samalsubrat/arion-aryabhatta/kicad source/wired&wireless led diagram.png

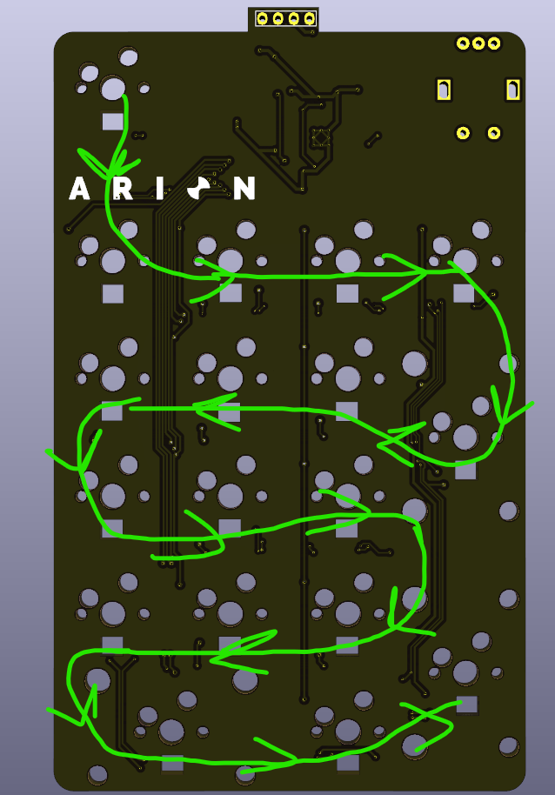
kicad source/wired&wireless led diagram.png
