samalsubrat/arion-aryabhatta/kicad source/WiredPcb/wired.step

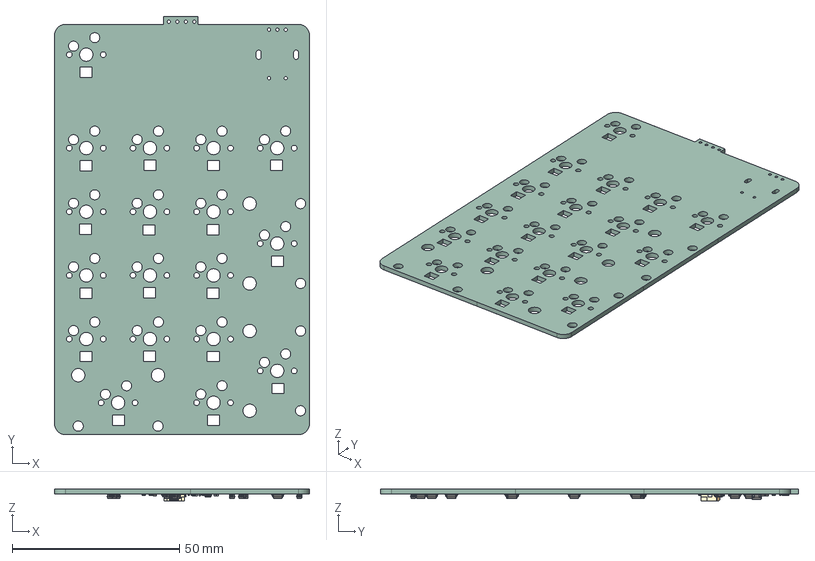
[picture p2: CAD file, 2025-07-30]
kicad source/WiredPcb/wired.step
76.3 x 125.2 x 3.60 mm
D_SOD-123 x 19
C_0402_1005Metric x 14
Fuse_0603_1608Metric
R_0402_1005Metric x 12
SOT-23-5
Crystal_SMD_2520-4Pin_2.5x2.0mm
lock
pins
WIRED_PCB
