samalsubrat/arion-aryabhatta/kicad source/WirelessPcb/WIRELESS.step

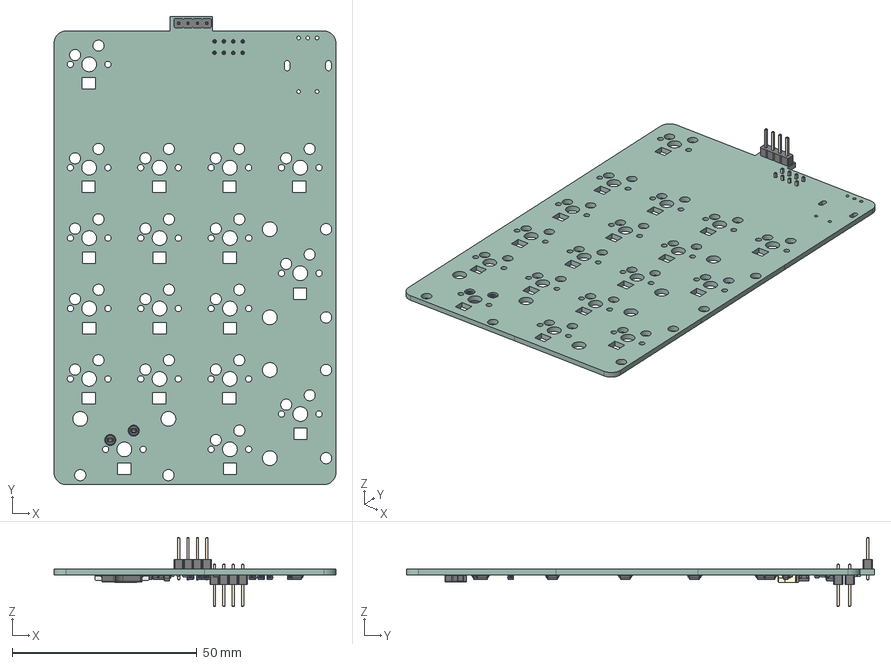
[picture p3: CAD file, 2025-07-30]
kicad source/WirelessPcb/WIRELESS.step
76.3 x 126.8 x 18.8 mm
PinHeader_1x04_P2.54mm_Vertical x 3
SOT-23 x 2
D_SOD-323F
R_0603_1608Metric x 5
SOT-23-5 x 2
Crystal_SMD_MicroCrystal_CM9V-T1A-2Pin_1.6x1.0mm
D_SOD-123 x 19
R_0402_1005Metric x 4
MX-Hotswap-Socket
lock
pins
WIRELESS_PCB
