samalsubrat/arion-aryabhatta/kicad source/db wireless/Unified-Daughterboard.kicad_pcb

## KiCad design kicad source/db wireless/Unified-Daughterboard.kicad_pcb (2025-07-30)

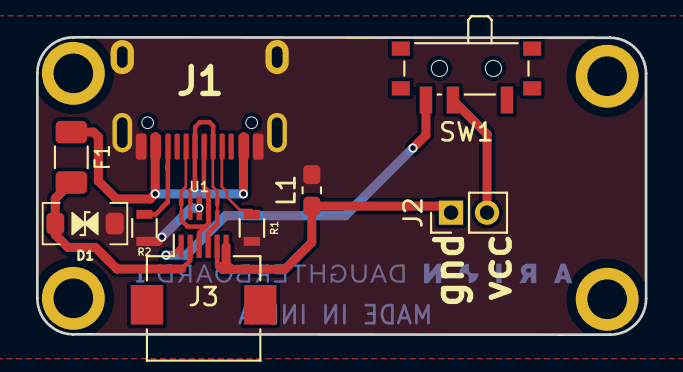
[picture p4: board Unified-Daughterboard.kicad_pcb from above]

Board: 2 copper layers, 33.8 x 16.5 mm, 14 parts (0 on the bottom side), 10 nets.

Parts:
D1: SMF9.0CA; D_SOD-123_Bidirectional
F1: ASMD1206-150; Fuse_1206_3216Metric
J1: TYPE-C-31-M12_13; TYPE-C-31-M-12
J2: Conn_01x02_Socket; PinHeader_1x02_P2.00mm_Vertical
J3: Conn_01x06_Pin; Hirose_FH12-6S-0.5SH_1x06-1MP_P0.50mm_Horizontal
L1: 60R@100MHz; L_0603_1608Metric_Pad1.05x0.95mm_HandSolder
MH1, MH3, MH4, MH4#2: Mount-M2; Generic-Mounthole
R1, R2: 5.1k; R_0603
SW1: SW_DPDT_x2; SW_SPDT_PCM12
U1: TPD4E05U06DQAR; USON-10_2.5x1.0mm_P0.5mm

Connections:
DA+: J1.A6 (D+), J1.B6 (D+), J3.3, U1.1 (IO1), U1.4 (D2+), U1.7 (NC), U1.10 (NC)
DA-: J1.A7 (D-), J1.B7 (D-), J3.4, U1.2 (IO2), U1.5 (D2-), U1.6 (NC), U1.9 (NC)
GND: J2.1, J3.5, J3.6, L1.1
GNDPWR: D1.1 (A1), J1.A1 (GND), J1.B1 (GND), J1.S (SHIELD), L1.2, R1.2, R2.2, U1.3 (GND), U1.8 (GND)
unnamed: J1.A5 (CC1), R1.1
unnamed: J1.B5 (CC2), R2.1
VBUS: F1.1, J1.A4 (VBUS), J1.B4 (VBUS)
VCC: D1.2 (A2), F1.2, J3.2
bat in: J2.2, SW1.2 (B)
bat+: J3.1, SW1.3 (C)
