samalsubrat/arion-aryabhatta/kicad source/WiredPcb/WIRED.kicad_pcb

## KiCad design kicad source/WiredPcb/WIRED.kicad_pcb (2025-07-30)

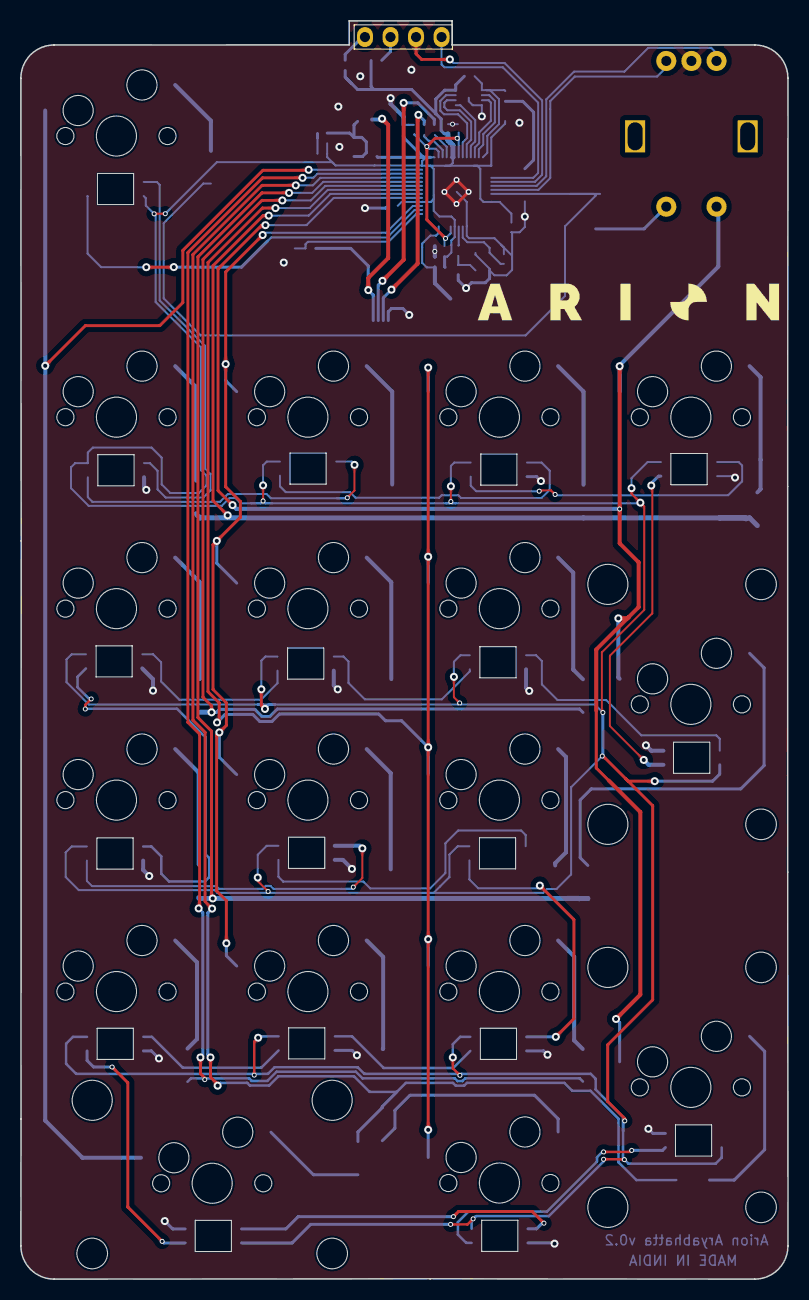
[picture p5: board WIRED.kicad_pcb from above]

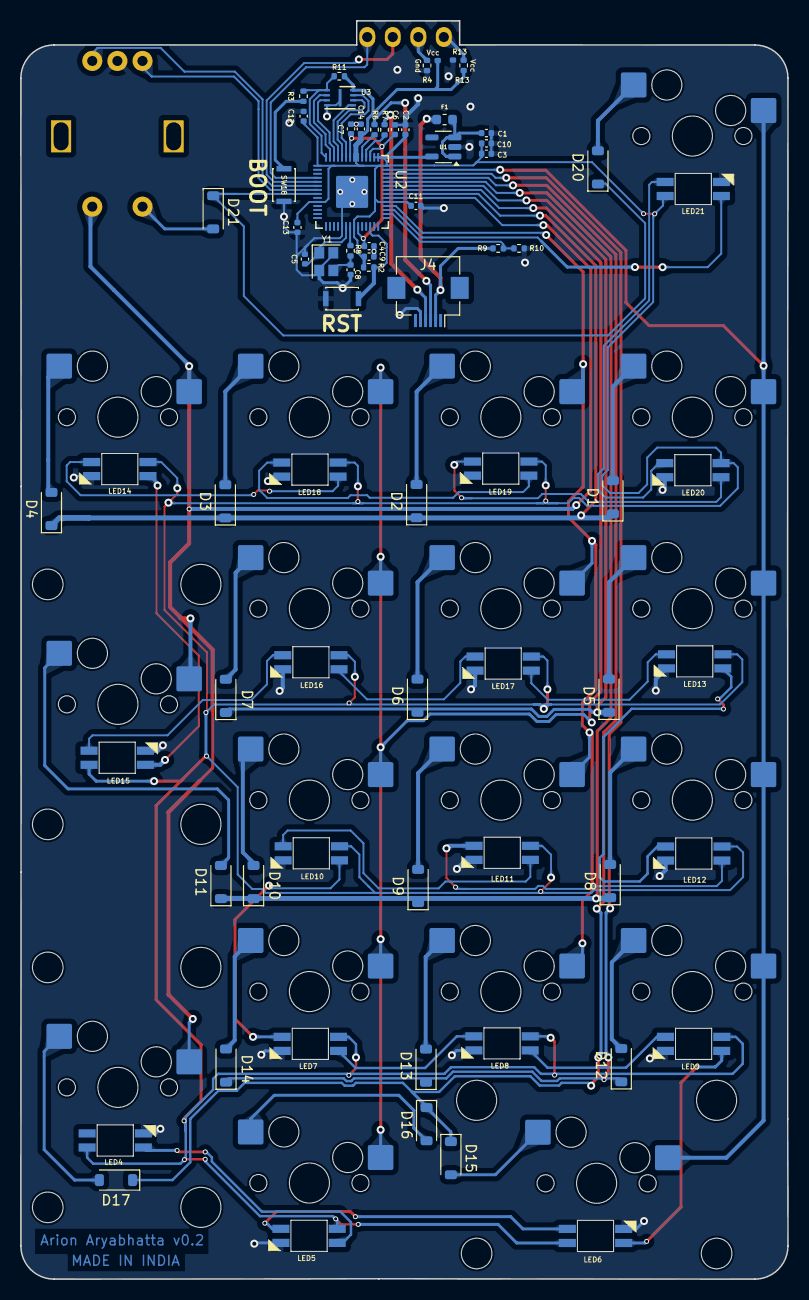
[picture p6: board WIRED.kicad_pcb from below]

Board: 2 copper layers, 76.3 x 125.2 mm, 91 parts (89 on the bottom side), 74 nets.

Parts:
C1, C2, C3, C4: 1µ; C_0402_1005Metric
C5, C8: 15p; C_0402_1005Metric
C6, C7, C9, C10, C11, C12, C13, C14: 100n; C_0402_1005Metric
D1, D2, D3, D4, D5, D6, D7, D8, D9, D10, D11, D12, D13, D14, D15, D16, D17, D20, D21: 1N4148W; D_SOD-123
F1: Polyfuse; Fuse_0603_1608Metric
J3: Conn_01x04_Pin; 128x64OLED
J4: Conn_01x06_Socket; Hirose_FH12-6S-0.5SH_1x06-1MP_P0.50mm_Horizontal
LED4, LED5, LED6, LED7, LED8, LED9, LED10, LED11, LED12, LED13, LED14, LED15, LED16, LED17, LED18, LED19, LED20, LED21: YS-SK6812MINI-E
R1, R4, R12, R13: 0k; R_0402_1005Metric
R2, R10, R11: 10k; R_0402_1005Metric
R3, R8: 1k; R_0402_1005Metric
R6, R7: 27; R_0402_1005Metric
R9: 5.1k; R_0402_1005Metric
SW0, SW1, SW2, SW3, SW4, SW5, SW6, SW8, SW9, SW10, SW11, SW12, SW13, SW16, SW20: KEYSW; MX-Hotswap-1U
SW7, SW14: KEYSW; MX-Hotswap-2U-Vertical-ReversedStabilizers
SW15: KEYSW; MX-Hotswap-2U-ReversedStabilizers
SW17, SW18: SW_Push; SW_SPST_CK_KXT3
SW19: Rotary_Encoder_Switch; RotaryEncoder_Alps_EC11E-Switch_Vertical_H20mm-keebio_modif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
U1: XC6210B332MR-G; SOT-23-5
U2: U2; QFN-56-1EP_7x7mm_P0.4mm_EP3.2x3.2mm
U3: U3; USON-8-1EP_3x2mm_P0.5mm_EP0.25x1.65mm
Y1: Crystal_GND24; Crystal_SMD_2520-4Pin_2.5x2.0mm

Connections:
+1V1: C4.1, C6.1, C7.1, U2.23 (DVDD), U2.45 (VREG_VOUT), U2.50 (DVDD)
+3V3: C2.1, C3.1, C9.1, C10.1, C11.1, C12.1, C13.1, C14.1, LED4.1 (VDD), LED5.1 (VDD), LED6.1 (VDD), LED7.1 (VDD), LED8.1 (VDD), LED9.1 (VDD), LED10.1 (VDD), LED11.1 (VDD), LED12.1 (VDD), LED13.1 (VDD), LED14.1 (VDD), LED15.1 (VDD), LED16.1 (VDD), LED17.1 (VDD), LED18.1 (VDD), LED19.1 (VDD), LED20.1 (VDD), LED21.1 (VDD), R1.2, R2.2, R11.2, R13.2, U1.5 (VOUT), U2.1 (IOVDD), U2.10 (IOVDD), U2.22 (IOVDD), U2.33 (IOVDD), U2.42 (IOVDD), U2.43 (ADC_AVDD), U2.44 (VREG_IN), U2.48 (USB_VDD), U2.49 (IOVDD), U3.8 (VCC)
+5V: C1.1, F1.2, U1.1 (VIN), U1.3 (EN)
/D+: J4.3, R6.1
/D-: J4.4, R7.1
/QSPI_D0: U2.53 (QSPI_SD0), U3.5 (DI(IO0))
/QSPI_D1: U2.55 (QSPI_SD1), U3.2 (DO(IO1))
/QSPI_D2: U2.54 (QSPI_SD2), U3.3 (IO2)
/QSPI_D3: U2.51 (QSPI_SD3), U3.7 (IO3)
/QSPI_SCLK: U2.52 (QSPI_SCLK), U3.6 (CLK)
/QSPI_~CS: R3.2, R11.1, U2.56 (QSPI_SS), U3.1 (~CS)
/VBUS_DET: R9.1, R10.2, U2.30 (GPIO19)
/~RESET: R2.1, SW17.2, U2.26 (RUN/~RST)
ENCA: SW19.A, U2.6 (GPIO4)
ENCB: SW19.B, U2.7 (GPIO5)
GND: C1.2, C2.2, C3.2, C4.2, C5.2, C6.2, C7.2, C8.2, C9.2, C10.2, C11.2, C12.2, C13.2, C14.2, J4.5, LED4.3 (VSS), LED5.3 (VSS), LED6.3 (VSS), LED7.3 (VSS), LED8.3 (VSS), LED9.3 (VSS), LED10.3 (VSS), LED11.3 (VSS), LED12.3 (VSS), LED13.3 (VSS), LED14.3 (VSS), LED15.3 (VSS), LED16.3 (VSS), LED17.3 (VSS), LED18.3 (VSS), LED19.3 (VSS), LED20.3 (VSS), LED21.3 (VSS), R4.1, R10.1, R12.1, SW17.1, SW18.1, SW19.C, U1.2 (GND), U2.19 (TESTEN), U2.57 (GND), U3.4 (GND), U3.9 (EP), Y1.2, Y1.4
LEDIN: LED21.4 (DIN), U2.31 (GPIO20)
unnamed: C8.1, R8.1, Y1.3
unnamed: D1.2 (A), SW0.2
unnamed: D2.2 (A), SW1.2
unnamed: D3.2 (A), SW2.2
unnamed: D4.2 (A), SW3.2
unnamed: D5.2 (A), SW4.2
unnamed: D6.2 (A), SW5.2
unnamed: D7.2 (A), SW6.2
unnamed: D8.2 (A), SW8.2
unnamed: D9.2 (A), SW9.2
unnamed: D10.2 (A), SW10.2
unnamed: D11.2 (A), SW7.2
unnamed: D12.2 (A), SW11.2
unnamed: D13.2 (A), SW12.2
unnamed: D14.2 (A), SW13.2
unnamed: D15.2 (A), SW15.2
unnamed: D16.2 (A), SW16.2
unnamed: D17.2 (A), SW14.2
unnamed: D20.2 (A), SW20.2
unnamed: D21.2 (A), SW19.S1
unnamed: J3.1, R13.1
unnamed: J3.2, R4.2
unnamed: LED4.4 (DIN), LED5.2 (DOUT)
unnamed: LED5.4 (DIN), LED6.2 (DOUT)
unnamed: LED6.4 (DIN), LED9.2 (DOUT)
unnamed: LED7.2 (DOUT), LED8.4 (DIN)
unnamed: LED8.2 (DOUT), LED9.4 (DIN)
unnamed: LED10.4 (DIN), LED11.2 (DOUT)
unnamed: LED7.4 (DIN), LED10.2 (DOUT)
unnamed: LED11.4 (DIN), LED12.2 (DOUT)
unnamed: LED12.4 (DIN), LED13.2 (DOUT)
unnamed: LED13.4 (DIN), LED17.2 (DOUT)
unnamed: LED14.4 (DIN), LED18.2 (DOUT)
unnamed: LED14.2 (DOUT), LED15.4 (DIN)
unnamed: LED15.2 (DOUT), LED16.4 (DIN)
unnamed: LED16.2 (DOUT), LED17.4 (DIN)
unnamed: LED18.4 (DIN), LED19.2 (DOUT)
unnamed: LED19.4 (DIN), LED20.2 (DOUT)
unnamed: LED20.4 (DIN), LED21.2 (DOUT)
unnamed: R3.1, SW18.2
unnamed: R7.2, U2.46 (USB_DM)
unnamed: R6.2, U2.47 (USB_DP)
unnamed: C5.1, U2.20 (XIN), Y1.1
unnamed: R8.2, U2.21 (XOUT)
VBUS: F1.1, J4.2, R9.2
col0: SW0.1, SW4.1, SW8.1, SW11.1, SW15.1, SW20.1, U2.41 (GPIO29_ADC3)
col1: SW1.1, SW5.1, SW9.1, SW12.1, U2.32 (GPIO21)
col2: SW2.1, SW6.1, SW10.1, SW13.1, SW16.1, U2.36 (GPIO24)
col3: SW3.1, SW7.1, SW14.1, SW19.S2, U2.34 (GPIO22)
row0: D1.1 (K), D2.1 (K), D3.1 (K), D4.1 (K), U2.35 (GPIO23)
row1: D5.1 (K), D6.1 (K), D7.1 (K), U2.37 (GPIO25)
row2: D8.1 (K), D9.1 (K), D10.1 (K), D11.1 (K), U2.38 (GPIO26_ADC0)
row3: D12.1 (K), D13.1 (K), D14.1 (K), U2.40 (GPIO28_ADC2)
row4: D15.1 (K), D16.1 (K), D17.1 (K), U2.39 (GPIO27_ADC1)
row5: D20.1 (K), D21.1 (K), U2.8 (GPIO6)
sda: J3.4, U2.4 (GPIO2)
sdl: J3.3, U2.5 (GPIO3)
