samalsubrat/arion-aryabhatta/kicad source/WirelessPcb/WIRELESS.kicad_pcb

## KiCad design kicad source/WirelessPcb/WIRELESS.kicad_pcb (2025-07-30)

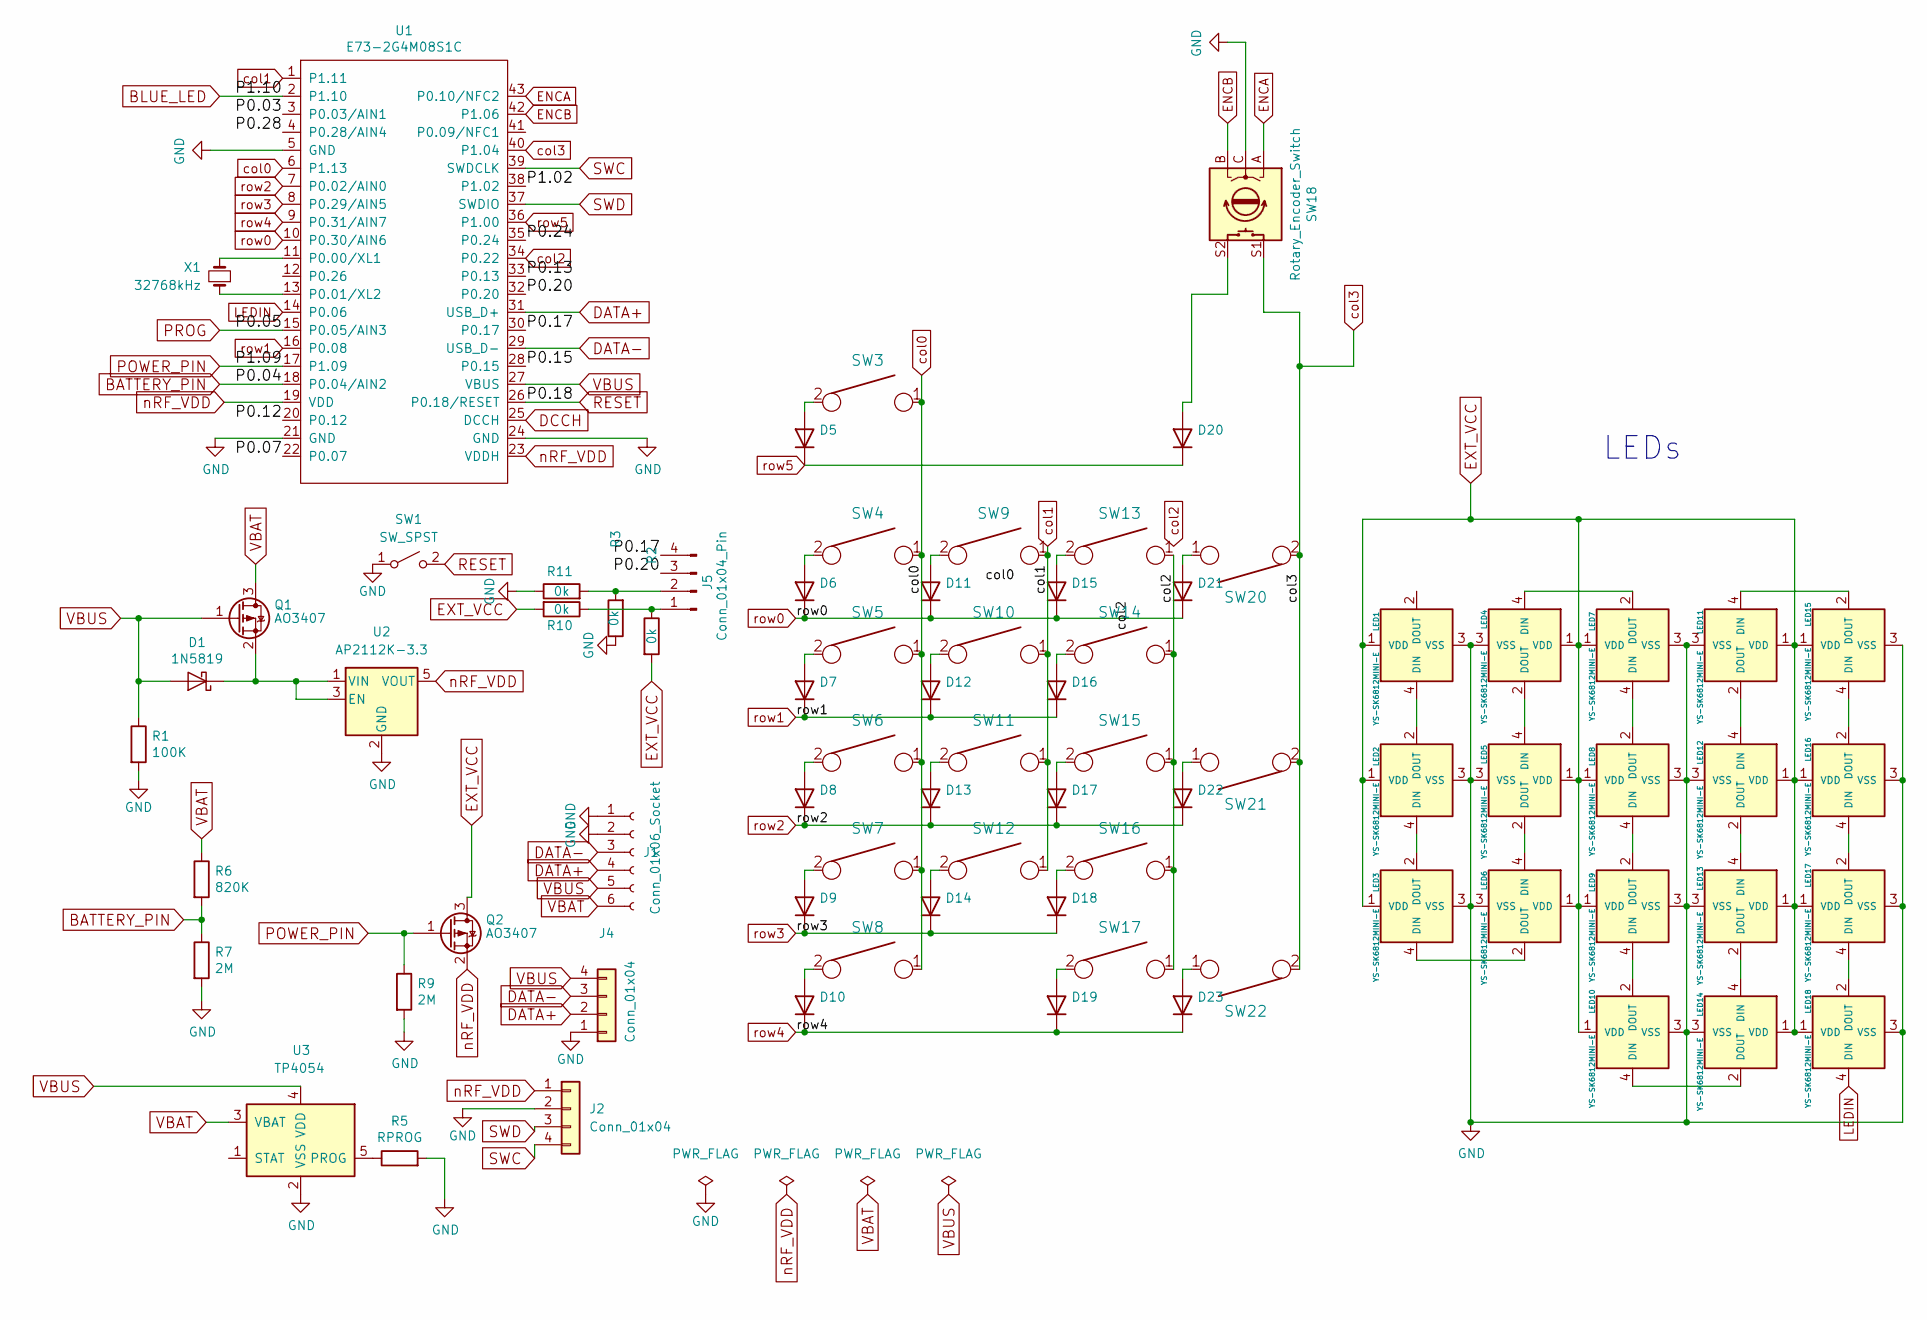
[picture p7: schematic WIRELESS.kicad_sch]

Parts:
D1: 1N5819; D_SOD-323F
D5, D6, D7, D8, D9, D10, D11, D12, D13, D14, D15, D16, D17, D18, D19, D20, D21, D22, D23: D_SOD-123
J1: Conn_01x06_Socket; Hirose_FH12-6S-0.5SH_1x06-1MP_P0.50mm_Horizontal
J2, J4: Conn_01x04; PinHeader_1x04_P2.54mm_Vertical
J5: Conn_01x04_Pin; PinHeader_1x04_P2.54mm_Vertical
LED1, LED2, LED3, LED4, LED5, LED6, LED7, LED8, LED9, LED10, LED11, LED12, LED13, LED14, LED15, LED16, LED17, LED18: YS-SK6812MINI-E
Q1, Q2: AO3407; SOT-23
R1: 100K; R_0603_1608Metric
R2, R3, R10, R11: 0k; R_0402_1005Metric; LCSC C25744
R5: RPROG; R_0603_1608Metric
R6: 820K; R_0603_1608Metric
R7, R9: 2M; R_0603_1608Metric
SW1: SW_SPST; SW_SPST_CK_KXT3
SW3, SW4, SW5, SW6, SW7, SW9, SW10, SW11, SW12, SW13, SW14, SW15, SW16, SW17, SW20: KEYSW; MX-Hotswap-1U
SW8: KEYSW; MX-Hotswap-2U-ReversedStabilizers
SW18: Rotary_Encoder_Switch; RotaryEncoder_Alps_EC11E-Switch_Vertical_H20mm-keebio_modif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
SW21, SW22: KEYSW; MX-Hotswap-2U-Vertical-ReversedStabilizers
U1: E73-2G4M08S1C; E73-2G4M08S1C-52840
U2: AP2112K-3.3; SOT-23-5
U3: TP4054; SOT-23-5
X1: 32768kHz

Connections:
/P0.03: U1.3 (P0.03/AIN1)
/P0.07: U1.22 (P0.07)
/P0.12: U1.20 (P0.12)
/P0.13: U1.33 (P0.13)
/P0.15: U1.28 (P0.15)
/P0.17: J5.4, U1.30 (P0.17)
/P0.20: J5.3, U1.32 (P0.20)
/P0.24: U1.35 (P0.24)
/P0.28: U1.4 (P0.28/AIN4)
/P1.02: U1.38 (P1.02)
BATTERY_PIN: R6.2, R7.1, U1.18 (P0.04/AIN2)
BLUE_LED: U1.2 (P1.10)
DATA+: J1.4, J4.2, U1.31 (USB_D+)
DATA-: J1.3, J4.3, U1.29 (USB_D-)
DCCH: U1.25 (DCCH)
ENCA: SW18.A, U1.43 (P0.10/NFC2)
ENCB: SW18.B, U1.42 (P1.06)
EXT_VCC: LED1.1 (VDD), LED2.1 (VDD), LED3.1 (VDD), LED4.1 (VDD), LED5.1 (VDD), LED6.1 (VDD), LED7.1 (VDD), LED8.1 (VDD), LED9.1 (VDD), LED10.1 (VDD), LED11.1 (VDD), LED12.1 (VDD), LED13.1 (VDD), LED14.1 (VDD), LED15.1 (VDD), LED16.1 (VDD), LED17.1 (VDD), LED18.1 (VDD), Q2.3 (D), R2.2, R10.2
GND: J1.1, J1.2, J2.2, J4.1, LED1.3 (VSS), LED2.3 (VSS), LED3.3 (VSS), LED4.3 (VSS), LED5.3 (VSS), LED6.3 (VSS), LED7.3 (VSS), LED8.3 (VSS), LED9.3 (VSS), LED10.3 (VSS), LED11.3 (VSS), LED12.3 (VSS), LED13.3 (VSS), LED14.3 (VSS), LED15.3 (VSS), LED16.3 (VSS), LED17.3 (VSS), LED18.3 (VSS), R1.2, R3.1, R5.2, R7.2, R9.2, R11.1, SW1.1 (A), SW18.C, U1.5 (GND), U1.21 (GND), U1.24 (GND), U2.2 (GND), U3.2 (VSS); also elsewhere on the board
LEDIN: LED18.4 (DIN), U1.14 (P0.06)
unnamed: D1.1 (K), Q1.2 (S), U2.1 (VIN), U2.3 (EN)
unnamed: D5.2 (A), SW3.2
unnamed: D6.2 (A), SW4.2
unnamed: D7.2 (A), SW5.2
unnamed: D8.2 (A), SW6.2
unnamed: D9.2 (A), SW7.2
unnamed: D10.2 (A), SW8.2
unnamed: D11.2 (A), SW9.2
unnamed: D12.2 (A), SW10.2
unnamed: D13.2 (A), SW11.2
unnamed: D14.2 (A), SW12.2
unnamed: D15.2 (A), SW13.2
unnamed: D16.2 (A), SW14.2
unnamed: D17.2 (A), SW15.2
unnamed: D18.2 (A), SW16.2
unnamed: D19.2 (A), SW17.2
unnamed: D20.2 (A), SW18.S2
unnamed: D21.2 (A), SW20.1
unnamed: D22.2 (A), SW21.1
unnamed: D23.2 (A), SW22.1
unnamed: J5.1, R2.1, R10.1
unnamed: J5.2, R3.2, R11.2
unnamed: LED1.4 (DIN), LED2.2 (DOUT)
unnamed: LED2.4 (DIN), LED3.2 (DOUT)
unnamed: LED3.4 (DIN), LED6.2 (DOUT)
unnamed: LED4.4 (DIN), LED7.2 (DOUT)
unnamed: LED4.2 (DOUT), LED5.4 (DIN)
unnamed: LED5.2 (DOUT), LED6.4 (DIN)
unnamed: LED7.4 (DIN), LED8.2 (DOUT)
unnamed: LED8.4 (DIN), LED9.2 (DOUT)
unnamed: LED10.4 (DIN), LED14.2 (DOUT)
unnamed: LED9.4 (DIN), LED10.2 (DOUT)
unnamed: LED11.4 (DIN), LED15.2 (DOUT)
unnamed: LED11.2 (DOUT), LED12.4 (DIN)
unnamed: LED12.2 (DOUT), LED13.4 (DIN)
unnamed: LED13.2 (DOUT), LED14.4 (DIN)
unnamed: LED15.4 (DIN), LED16.2 (DOUT)
unnamed: LED16.4 (DIN), LED17.2 (DOUT)
unnamed: LED17.4 (DIN), LED18.2 (DOUT)
unnamed: U1.11 (P0.00/XL1), X1.2
unnamed: U1.13 (P0.01/XL2), X1.1
unnamed: R5.1, U3.5 (PROG)
POWER_PIN: Q2.1 (G), R9.1, U1.17 (P1.09)
PROG: U1.15 (P0.05/AIN3)
RESET: SW1.2 (B), U1.26 (P0.18/RESET); also elsewhere on the board
SWC: J2.4, U1.39 (SWDCLK)
SWD: J2.3, U1.37 (SWDIO)
VBAT: J1.6, Q1.3 (D), R6.1, U3.3 (VBAT)
VBUS: D1.2 (A), J1.5, J4.4, Q1.1 (G), R1.1, U1.27 (VBUS), U3.4 (VDD)
col0: SW3.1, SW4.1, SW5.1, SW6.1, SW7.1, SW8.1, U1.6 (P1.13)
col1: SW9.1, SW10.1, SW11.1, SW12.1, U1.1 (P1.11)
col2: SW13.1, SW14.1, SW15.1, SW16.1, SW17.1, U1.34 (P0.22)
col3: SW18.S1, SW20.2, SW21.2, SW22.2, U1.40 (P1.04)
nRF_VDD: J2.1, Q2.2 (S), U1.19 (VDD), U1.23 (VDDH), U2.5 (VOUT)
row0: D6.1 (K), D11.1 (K), D15.1 (K), D21.1 (K), U1.10 (P0.30/AIN6)
row1: D7.1 (K), D12.1 (K), D16.1 (K), U1.16 (P0.08)
row2: D8.1 (K), D13.1 (K), D17.1 (K), D22.1 (K), U1.7 (P0.02/AIN0)
row3: D9.1 (K), D14.1 (K), D18.1 (K), U1.8 (P0.29/AIN5)
row4: D10.1 (K), D19.1 (K), D23.1 (K), U1.9 (P0.31/AIN7)
row5: D5.1 (K), D20.1 (K), U1.36 (P1.00)

Notes on the sheet:
LEDs

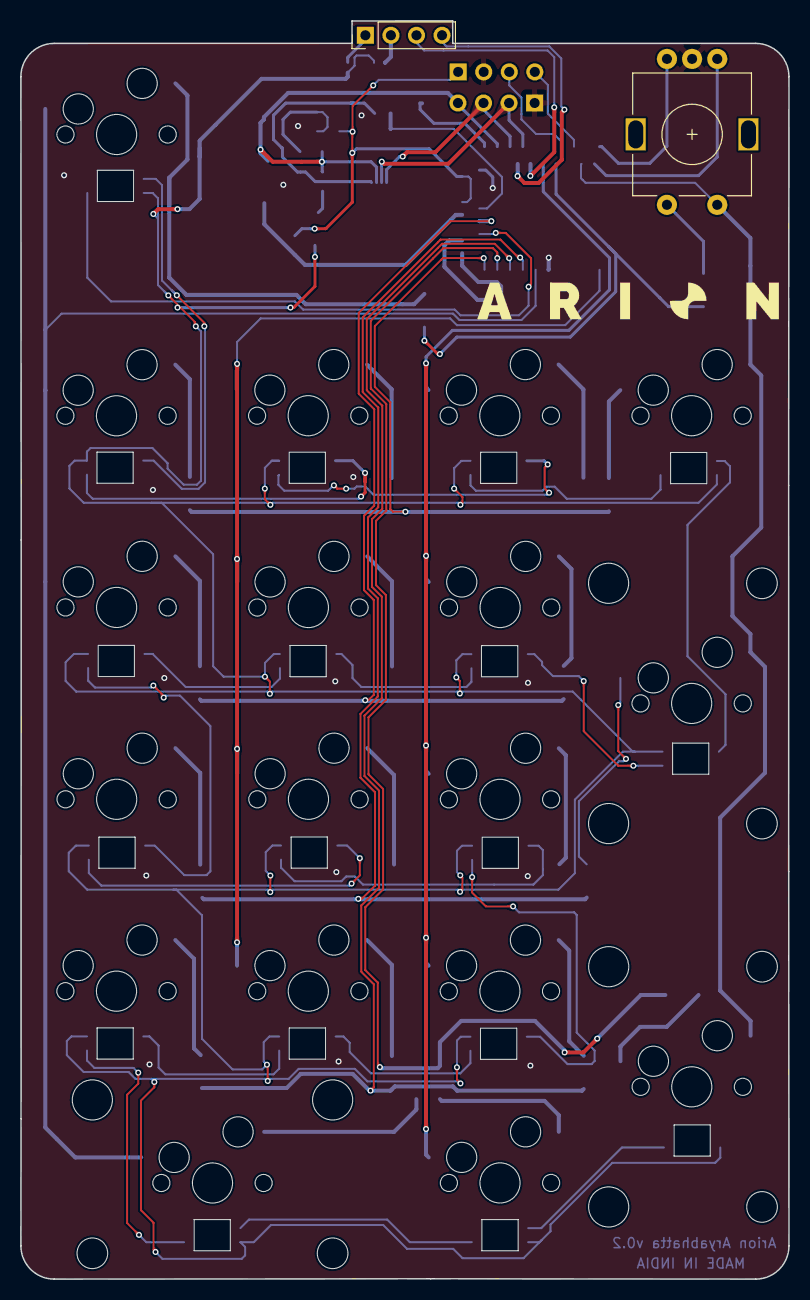
[picture p8: board WIRELESS.kicad_pcb from above]

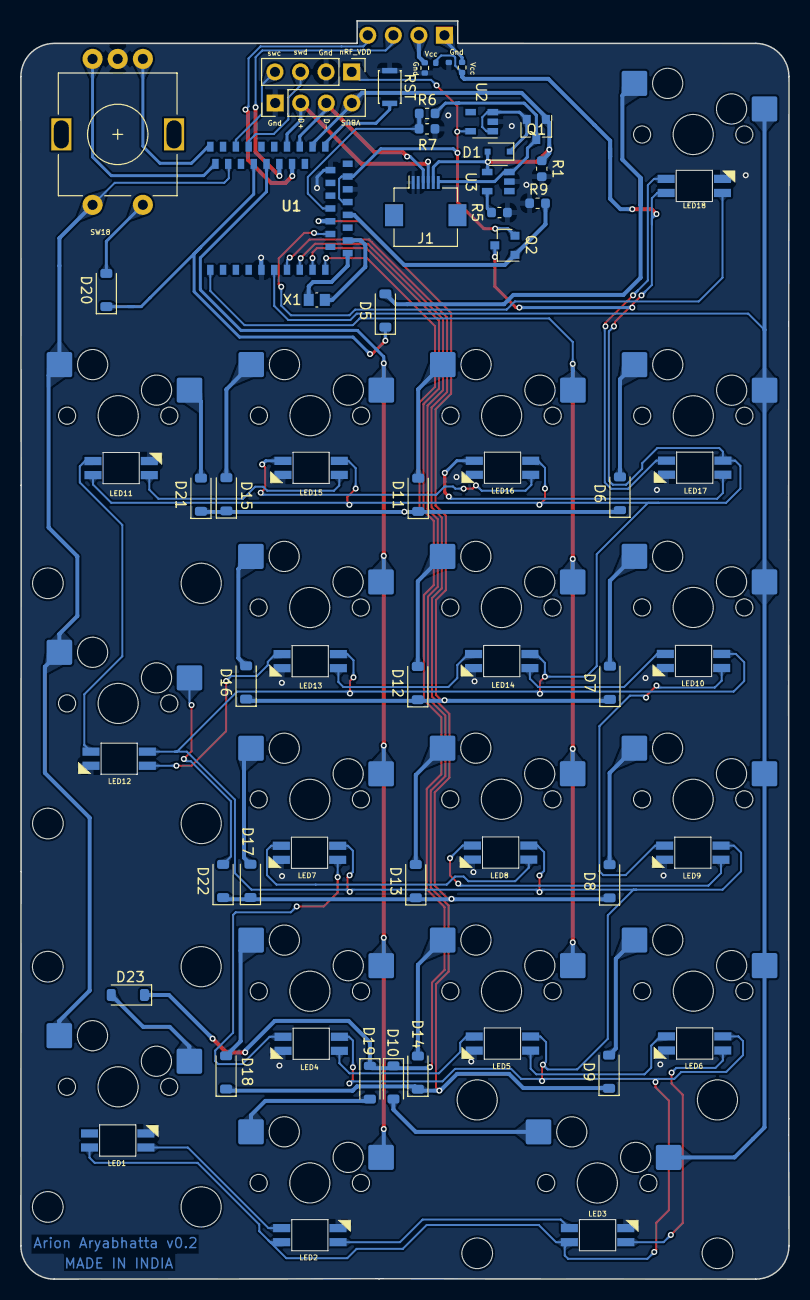
[picture p9: board WIRELESS.kicad_pcb from below]

Board: 2 copper layers, 76.3 x 125.0 mm, 77 parts (76 on the bottom side), 69 nets.

Other parts of the board:
RST: TS2306A; SW_SPST_CK_KXT3

Their connections:
GND: RST.1 (A); also elsewhere on the board
RESET: RST.2 (B); also elsewhere on the board
